cwalther/picopew-hardware/Case.stl

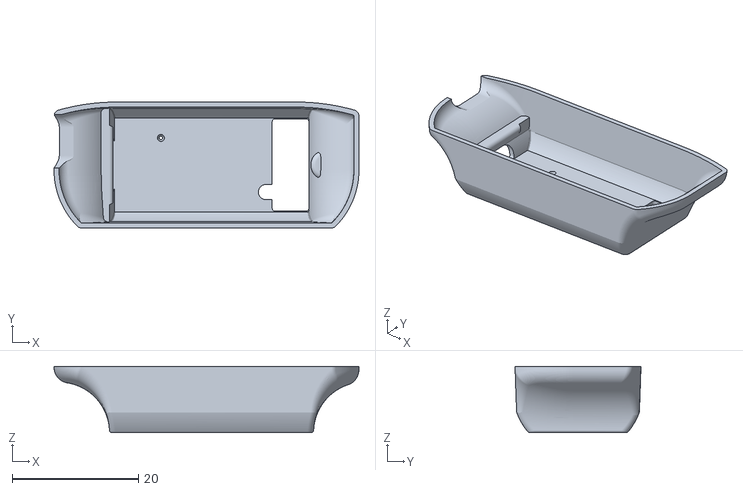
[picture p1: CAD file, 2019-11-16]
Case.stl
48.4 x 20.0 x 10.5
