cwalther/picopew-hardware/picopew.brd

## EAGLE design picopew.brd (2019-11-03)

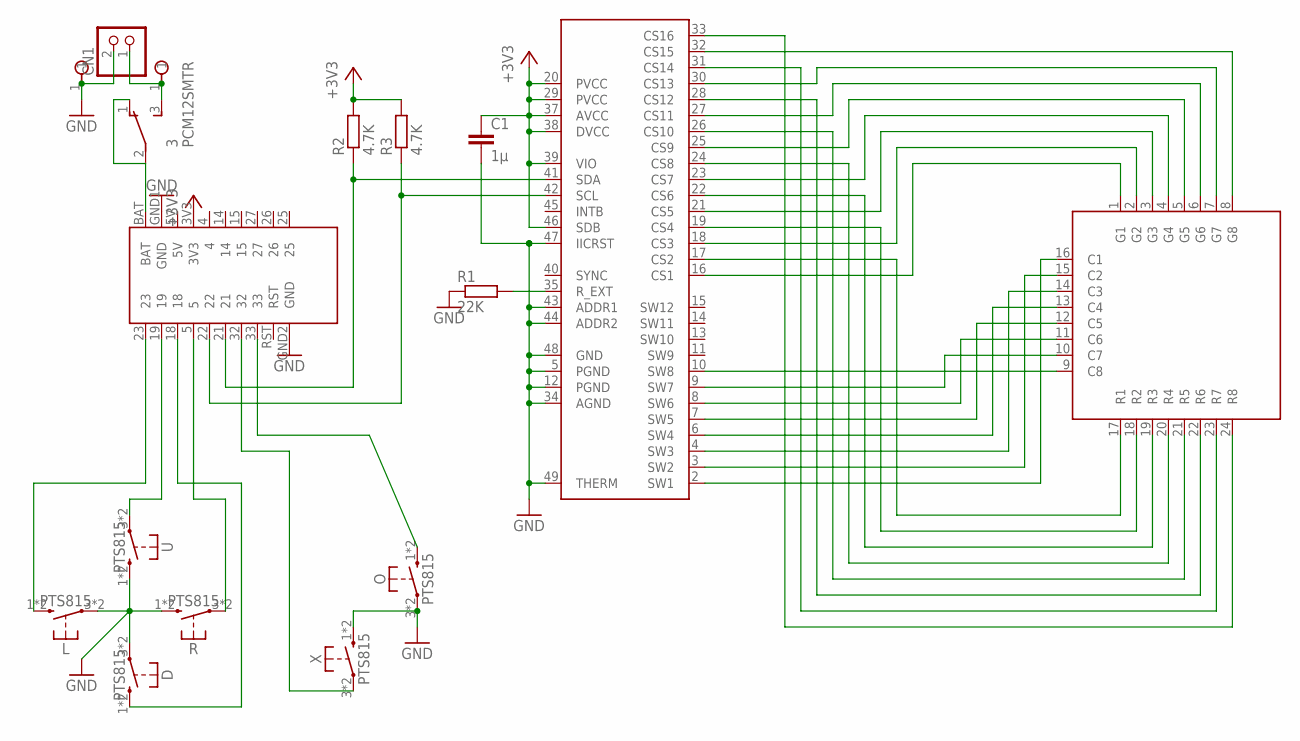
[picture p2: schematic picopew.sch]

Parts:
1: KYX-788AHG
2: TINYPICO
3: PCM12SMTR; MICROSLIDESWITCH
4, 5: SINGLEPAD
C1: 1µ; C0805
CN1: JST_2PIN-SMT-RA; JST-PH-2-SMT-RA
D: PTS815; MICROPUSHBUTTON
L: PTS815; MICROPUSHBUTTON
O: PTS815; MICROPUSHBUTTON
R: PTS815; MICROPUSHBUTTON
R1: 22K; R0805
R2, R3: 4.7K; R0805
U: PTS815; MICROPUSHBUTTON
U1: IS31FL3733-TQLS4; TQFP48
X: PTS815; MICROPUSHBUTTON

Connections:
5V: 2.5V
+3V3: 2.3V3, C1.1, R2.2, R3.2, U1.20 (PVCC), U1.29 (PVCC), U1.37 (AVCC), U1.38 (DVCC), U1.39 (VIO), U1.46 (SDB)
GND: 2.GND1 (GND), 2.GND2 (GND), 5.1, C1.2, CN1.2 (1), D.3, D.4, L.3, L.4, O.3, O.4, R.1 (S), R.2 (S), R1.1, U.1 (S), U.2 (S), U1.5 (PGND), U1.12 (PGND), U1.34 (AGND), U1.43 (ADDR1), U1.44 (ADDR2), U1.47 (IICRST), U1.48 (GND), U1.49 (THERM), X.1 (S), X.2 (S)
unnamed: 1.16 (C1), U1.2 (SW1)
unnamed: 1.15 (C2), U1.3 (SW2)
unnamed: 1.14 (C3), U1.4 (SW3)
unnamed: 1.13 (C4), U1.6 (SW4)
unnamed: 1.12 (C5), U1.7 (SW5)
unnamed: 1.11 (C6), U1.8 (SW6)
unnamed: 1.10 (C7), U1.9 (SW7)
unnamed: 1.9 (C8), U1.10 (SW8)
unnamed: 1.1 (G1), U1.16 (CS1)
unnamed: 1.17 (R1), U1.17 (CS2)
unnamed: 1.2 (G2), U1.18 (CS3)
unnamed: 1.18 (R2), U1.19 (CS4)
unnamed: 1.3 (G3), U1.21 (CS5)
unnamed: 1.19 (R3), U1.22 (CS6)
unnamed: 1.4 (G4), U1.23 (CS7)
unnamed: 1.20 (R4), U1.24 (CS8)
unnamed: 1.5 (G5), U1.25 (CS9)
unnamed: 1.21 (R5), U1.26 (CS10)
unnamed: 1.6 (G6), U1.27 (CS11)
unnamed: 1.22 (R6), U1.28 (CS12)
unnamed: 1.7 (G7), U1.30 (CS13)
unnamed: 1.23 (R7), U1.31 (CS14)
unnamed: 1.8 (G8), U1.32 (CS15)
unnamed: 1.24 (R8), U1.33 (CS16)
unnamed: 2.21, R2.1, U1.41 (SDA)
unnamed: 2.22, R3.1, U1.42 (SCL)
unnamed: R1.2, U1.35 (R_EXT)
unnamed: 2.33, O.1 (S), O.2 (S)
unnamed: 2.32, X.3, X.4
unnamed: 2.BAT, 3.1 (O), 3.2
unnamed: 3.3 (S), 4.1, CN1.1 (2)
unnamed: 2.5, R.3, R.4
unnamed: 2.18, D.1 (S), D.2 (S)
unnamed: 2.19, U.3, U.4
unnamed: 2.23, L.1 (S), L.2 (S)

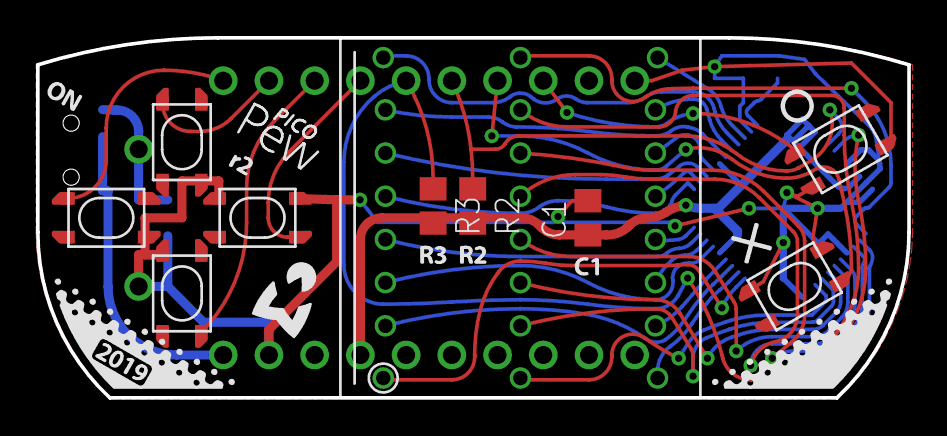
[picture p3: board picopew.brd from above]

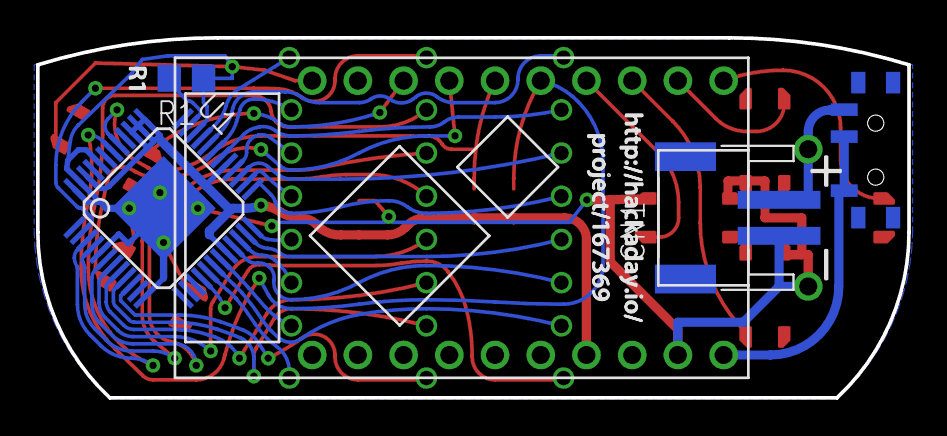
[picture p4: board picopew.brd from below]

Board: 2 copper layers, 48.4 x 20.0 mm, 74 parts (42 on the bottom side), 37 nets.

Other parts of the board:
U$1: PICOPEW-O
U$2: PICOPEW-CORNER-L
U$3: PICOPEW-X
U$4: PLUS
U$5: PICOPEW
U$6, U$72: CHAR114
U$7: CWLOGO-4
U$8: PICOPEW-CORNER-R
U$9, U$15, U$21: CHAR050
U$10: CHAR079
U$11: CHAR078
U$12: MINUS
U$14, U$20, U$22: CHAR082
U$16: CHAR048
U$17, U$19, U$25, U$26: CHAR049
U$18, U$31: CHAR057
U$23, U$29: CHAR051
U$24: CHAR067
U$27, U$30: CHAR054
U$28: CHAR055
U$52, U$59: CHAR104
U$53, U$54, U$77: CHAR116
U$55, U$71: CHAR112
U$56: CHAR058
U$57, U$58, U$70, U$78: CHAR047
U$60, U$63, U$65: CHAR097
U$61, U$76: CHAR099
U$62: CHAR107
U$64: CHAR100
U$66: CHAR121
U$67: CHAR046
U$68: CHAR105
U$69, U$73: CHAR111
U$74: CHAR106
U$75: CHAR101
