cwalther/picopew-hardware/(commit log)

2019-08-20 Routed and prettified layout.
    [picopew.brd, picopew.sch]
2019-08-28 Silkscreen labeling and decorations.
    [picopew.brd]
2019-11-03 Larger drill for the headers and smaller vias.
    [picopew.brd, picopew.sch]
2019-11-03 Move the outer pins of the LED matrix 0.15 mm farther out.
    As far as the DRC allows.
    [picopew.brd, picopew.sch]
2019-11-03 Add JST connector footprint for those who want to connect their battery that way.
    [picopew.brd, picopew.sch]
2019-11-03 Move R2 and R3 to be more centered under the LED matrix.
    Hoping this reduces the likelihood that the resistors will prevent the matrix from sitting flush on the board.
    [picopew.brd]
2019-11-13 Add 3D-printed enclosure design.
    [Case.stl]
2019-11-16 Tweaks to the enclosure from the first print.
    - Deepen switch cutout – 1.6 mm is the correct depth, but for some reason (springback by the cantilevered shape?) it turned out only 1.1 mm – trying 2.0 mm now.
    - USB cutout corners can be rounded more, should reduce sagging of the bridge.
    - Move the right rail by 0.1 mm for tighter fit.
    - Add holes for LEDs.
    - Edges redone in a more rounded way for a more pleasant look and feel.
    [Case.stl]
